RalphBacon/ESP8266-Home-Alone-Vulnerable-Person-Monitor/Hand Drawn Documentation/Circuit Diagram (Hand Drawn) Draft - 2.jpg

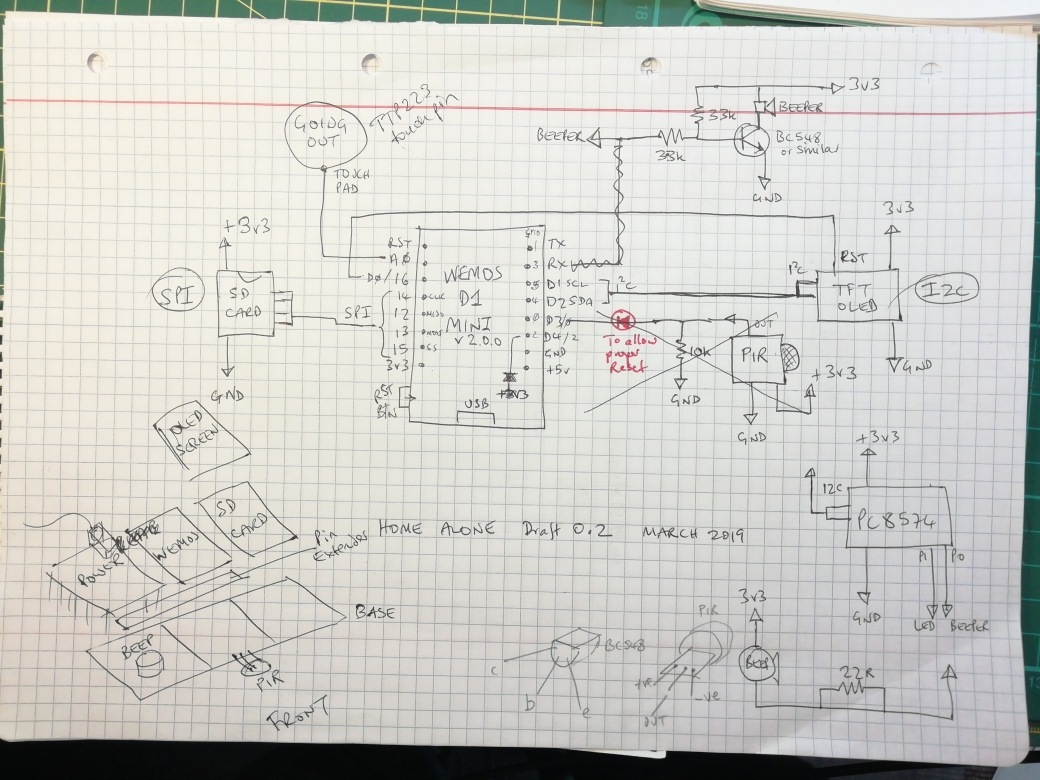
Hand Drawn Documentation/Circuit Diagram (Hand Drawn) Draft - 2.jpg
