RalphBacon/ESP8266-Home-Alone-Vulnerable-Person-Monitor/README.md

# ESP8266 Home Alone (Vulnerable Person Monitor)
Monitor that a person is still OK without an intrusive camera

My project to monitor that my mum was OK, by monitoring her general activity / movement, has been running for several months now.

# See https://wwww.YouTube.com/ralphbacon video #154
### (Direct link to video: https://youtu.be/5IxOUxZFfnk)

## Send me your JLCPCB Username if you need PCB coupons (Limited Quantity)
## $2 for PCB Prototype(Any Color): https://jlcpcb.com/

This project uses a Wemos D1 Mini ESP8266 to upload data to ThingSpeak, and IoT data storage repository; very easy to use and FREE. In the video I'll show you the graph that is automatically created.

Even better is the Android Phone app that links directly to your ThingSpeak channel and can display the chart in real time. You can customise the chart somewhat and I find this app essential.

I'm going to build V2 very soon and for this I have developed a 4-layer PCB (just about, anyway). It looks lovely in Matt Black, at no extra charge from JLCPCB.com - watch the video to see it!

### LINKS     LINKS     LINKS     LINKS    

Android ThingSpeak viewer, free version (ThingView - ThingSpeak viewer)  
https://play.google.com/store/apps/details?id=com.cinetica_tech.thingview  

ThingView paid for version £1.69   
https://play.google.com/store/apps/details?id=com.cinetica_tech.thingview.full

Thingspeak data repository - free and easy to do (I estimate that you can set it all up in 1 hour)  
https://www.thingspeak.com

**Banggood ESP8266 Wemos D1 Module** 
#### Until July 31st, 2019 just $2.29 when sent from China!!!  
https://www.banggood.com/Geekcreit-D1-mini-V2_2_0-WIFI-Internet-Development-Board-Based-ESP8266-4MB-FLASH-ESP-12S-Chip-p-1143874.html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  

**Tripler Base Board**  
https://www.banggood.com/Tripler-Base-Socket-V1_0_0-For-D1-Mini-Development-Board-p-1184905.html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

**SD Card**  
https://www.banggood.com/Geekcreit-Micro-SD-Card-Shield-For-D1-Mini-TF-WiFi-ESP8266-Compatible-SD-Wireless-Module-For-Arduino-p-1160026.html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

**OLED Screen**  
https://www.banggood.com/Geekcreit-0_66-Inch-OLED-Display-Shield-For-D1-Mini-64X48-IIC-I2C-Compatible-p-1093397.html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

**Single prototyping board**  
https://www.banggood.com/5Pcs-ProtoBoard-Shield-Expansion-Board-For-D1-Mini-Double-Sided-Perf-Board-Compatible-p-1185112.html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

---

If you like this video please give it a thumbs up, share it and if you're not already subscribed please consider doing so and joining me on my Arduinite journey

My channel and blog are here:  
\------------------------------------------------------------------  
https://www.youtube.com/RalphBacon  
https://ralphbacon.blog  
\------------------------------------------------------------------
