RalphBacon/ESP8266-Home-Alone-Vulnerable-Person-Monitor/Hand Drawn Documentation/Circuit Diagram (Hand Drawn) Draft - 4.jpg

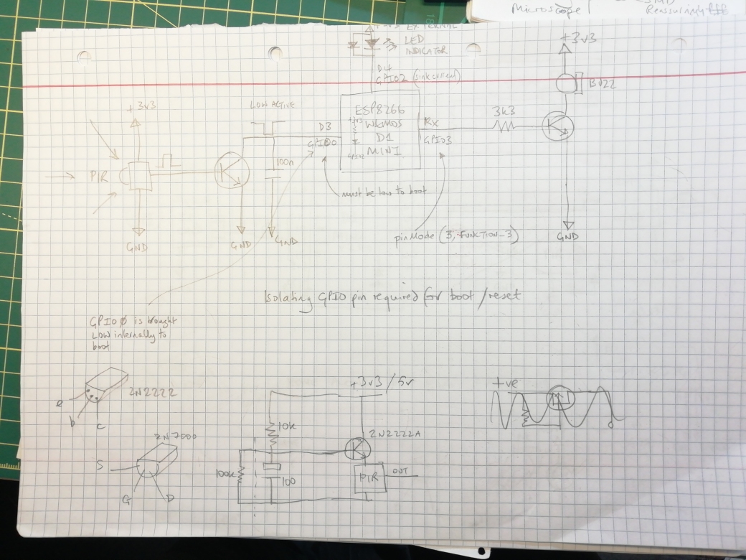
Hand Drawn Documentation/Circuit Diagram (Hand Drawn) Draft - 4.jpg
