RalphBacon/ESP8266-Home-Alone-Vulnerable-Person-Monitor/HomeAloneYouTube/HelperRoutines.cpp

#include <cstring>
#include <sys/types.h>
#include <Arduino.h>
#include <HardwareSerial.h>

// We're reading parameters from an SD card
#include <SD.h>

// Short cut to std namespace (eg std::string)
using namespace std;
